broken-giobbe/ceci-hardware/README.md

# ceci-hardware
Hardware design files for our IoT sensor/actuator nodes based around the
ESP8266.

There are currently two hardware revisions:
 * rev0 (first prototype where sensor and actuator can be split)
 * rev1 (designed to act as a thermostat and fit into a vimar plana power box)
