broken-giobbe/ceci-hardware/ceci-gerbers/Transcode Report.txt

   ---- Transcoding 'C:\userdata\Arduino\ceci\ceci-hardware\ceci-gerbers\cece-pcb-B_Mask.gbr' ----   Wed Jul 21 10:57:14 2021

D17   --> D100
D18   --> D101
D19   --> D102
D20   --> D103
D21   --> D104
D22   --> D105
D24   --> D106
D25   --> D107
D26   --> D108
D27   --> D109
D28   --> D110
D29   --> D111
D30   --> D112
D31   --> D113
D32   --> D114
D33   --> D115
D34   --> D116
D35   --> D117
-----------------------------------------------------------------

   ---- Transcoding 'C:\userdata\Arduino\ceci\ceci-hardware\ceci-gerbers\cece-pcb-B_Paste.gbr' ----   Wed Jul 21 10:57:14 2021

D11   --> D118
D12   --> D119
D13   --> D120
D14   --> D121
-----------------------------------------------------------------

   ---- Transcoding 'C:\userdata\Arduino\ceci\ceci-hardware\ceci-gerbers\cece-pcb-B_SilkS.gbr' ----   Wed Jul 21 10:57:14 2021

D10   --> D122
D11   --> D123
D12   --> D124
-----------------------------------------------------------------

   ---- Transcoding 'C:\userdata\Arduino\ceci\ceci-hardware\ceci-gerbers\cece-pcb-Edge_Cuts.gbr' ----   Wed Jul 21 10:57:14 2021

D10   --> D125
D11   --> D126
-----------------------------------------------------------------

   ---- Transcoding 'C:\userdata\Arduino\ceci\ceci-hardware\ceci-gerbers\cece-pcb-F_Cu.gbr' ----   Wed Jul 21 10:57:14 2021

D17   --> D127
D18   --> D128
D19   --> D129
D20   --> D130
D21   --> D131
D22   --> D132
D24   --> D133
D25   --> D134
D26   --> D135
D27   --> D136
D28   --> D137
D29   --> D138
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

   ---- Transcoding 'C:\userdata\Arduino\ceci\ceci-hardware\ceci-gerbers\cece-pcb-F_SilkS.gbr' ----   Wed Jul 21 11:03:52 2021

D10   --> D158
D11   --> D159
D12   --> D160
-----------------------------------------------------------------
