broken-giobbe/ceci-hardware/cece-pcb.kicad_pcb

## KiCad design cece-pcb.kicad_pcb (2022-04-16)

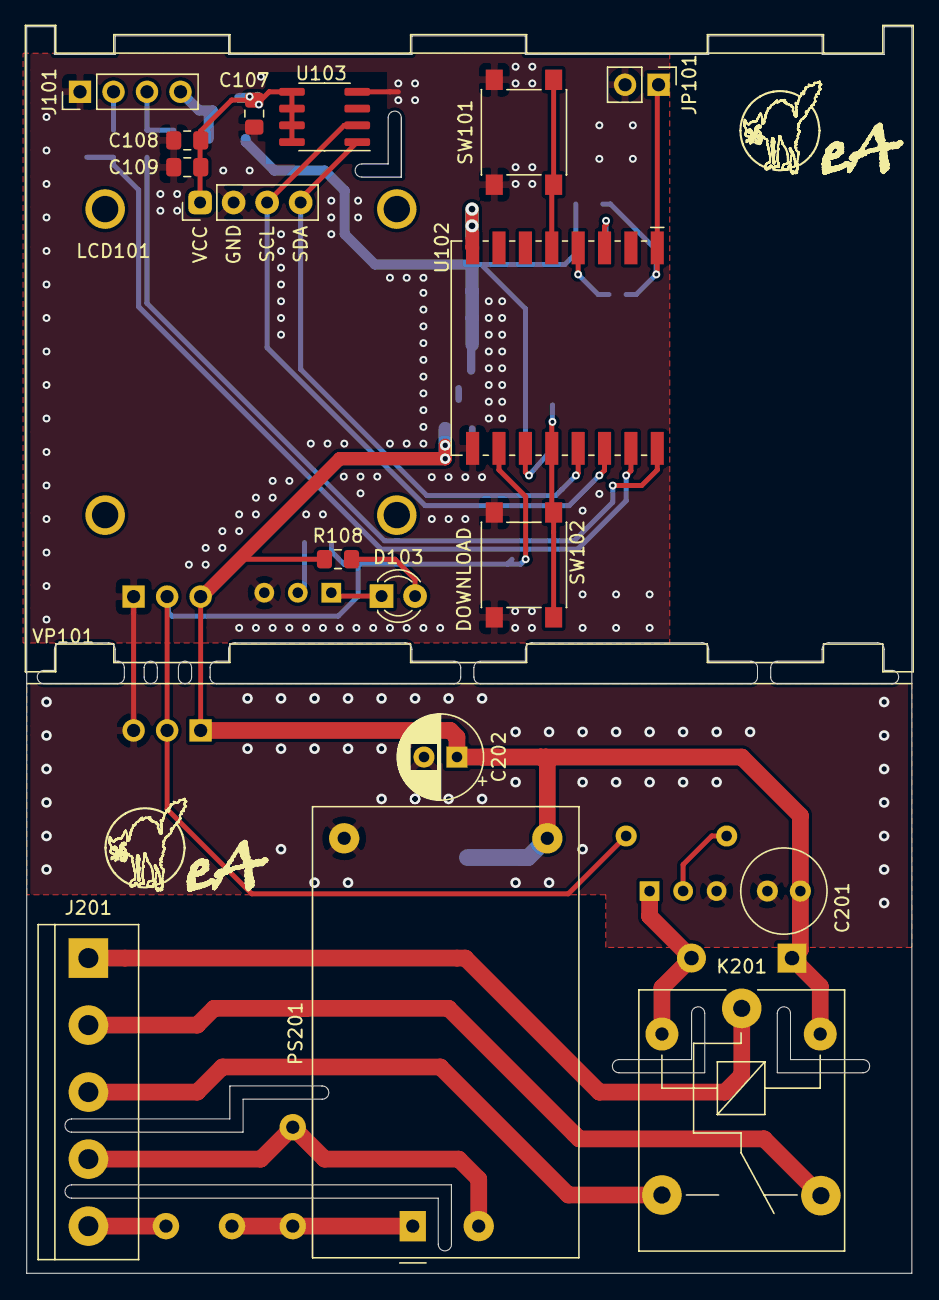
[picture p1: board cece-pcb.kicad_pcb from above]

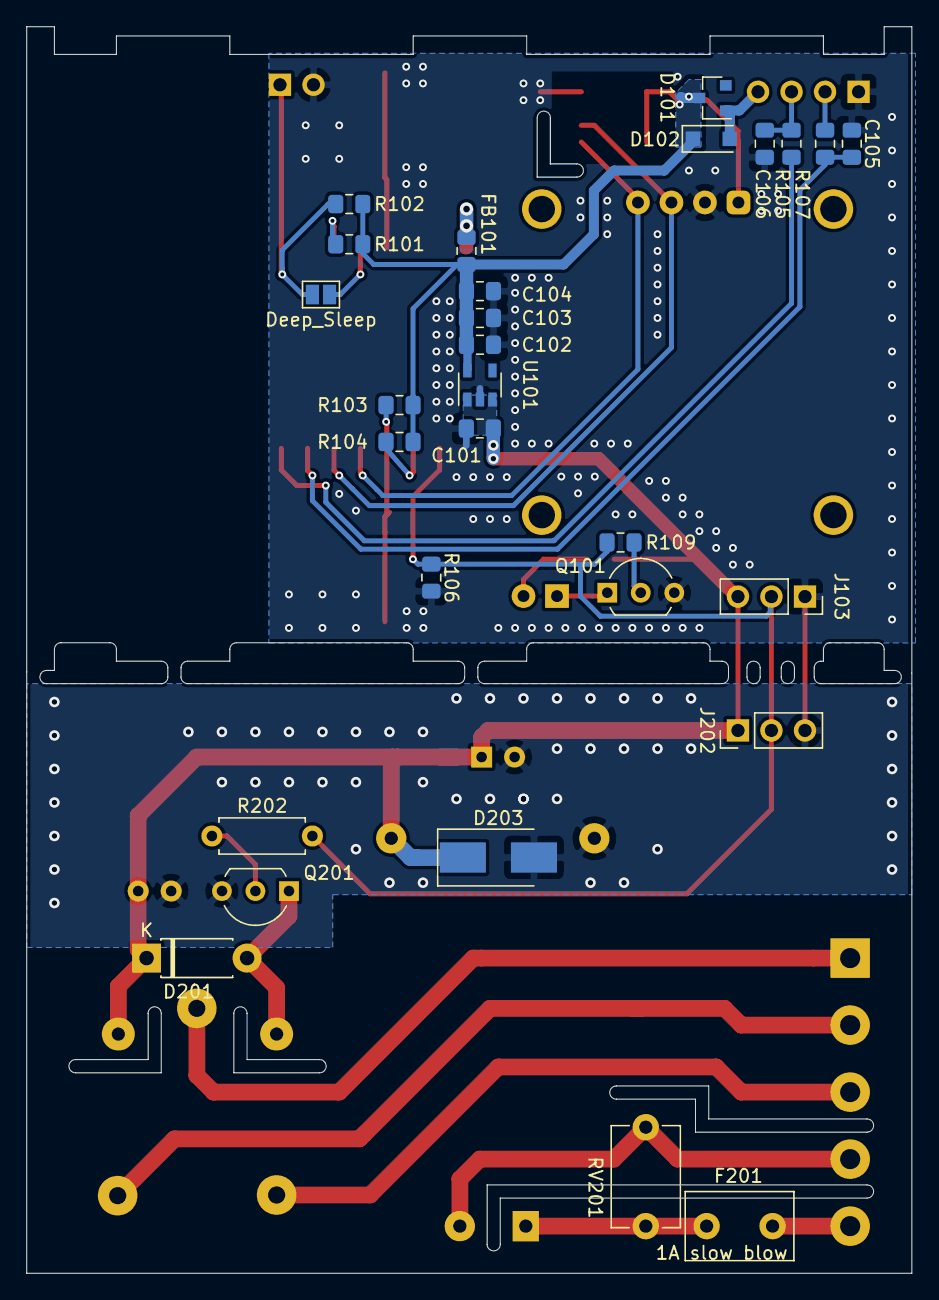
[picture p2: board cece-pcb.kicad_pcb from below]

Board: 2 copper layers, 67.1 x 94.5 mm, 48 parts (28 on the bottom side), 29 nets.

Parts:
C101, C103: 1u; C_0805_2012Metric_Pad1.15x1.40mm_HandSolder
C102, C108: 10u; C_0805_2012Metric_Pad1.15x1.40mm_HandSolder
C104, C107, C109: 100nF; C_0805_2012Metric_Pad1.15x1.40mm_HandSolder
C105, C106: 100p; C_0805_2012Metric_Pad1.15x1.40mm_HandSolder
C201: 10u; C_Radial_D6.3mm_H5.0mm_P2.50mm
C202: 100u; CP_Radial_D6.3mm_P2.50mm
D101: Schottky SOT-23; D_SOT-23_ANK
D102: Schottky SOD-123; D_SOD-123F
D103: LED; LED_D3.0mm
D201: 1N4001; D_DO-41_SOD81_P7.62mm_Horizontal
D203: SMBJ5.0A; D_SMB_Handsoldering
EA101, EA201: a_black_cat
F201: 1A slow blow; C_Disc_D8.0mm_W5.0mm_P5.00mm
FB101: Ferrite_Bead; R_0805_2012Metric_Pad1.15x1.40mm_HandSolder
J101: SERIAL; PinHeader_1x04_P2.54mm_Vertical
J103: Conn_01x03_Male; PinSocket_1x03_P2.54mm_Vertical
J201: VAC; TerminalBlock_bornier-5_P5.08mm
J202: Conn_01x03_Female; PinHeader_1x03_P2.54mm_Vertical
JP101: RST; PinHeader_1x02_P2.54mm_Vertical
JP103: Deep_Sleep; SolderJumper-2_P1.3mm_Open_Pad1.0x1.5mm
K201: SANYOU_SRD_Form_C; Relay_SPDT_SANYOU_SRD_Series_Form_C
LCD101: I2C_LCD_display; I2C_LCD_display_0.96
PS201: HLK-PM01; Converter_ACDC_HiLink_HLK-PMxx
Q101, Q201: Q_NPN; TO-92L_Inline_Wide
R101, R102, R103, R104, R106, R109: 10k; R_0805_2012Metric_Pad1.15x1.40mm_HandSolder
R105, R107, R108: 330; R_0805_2012Metric_Pad1.15x1.40mm_HandSolder
R202: 1k; R_Axial_DIN0207_L6.3mm_D2.5mm_P7.62mm_Horizontal
RV201: 10D561K; C_Disc_D7.5mm_W5.0mm_P7.50mm
SW101, SW102: SW_Push; SW_Push_1P1T_NO_6x6mm_H9.5mm
U101: TLV75533PDBV; SOT-23-5
U102: ESP-12F/ESP07; ESP-07
U103: LM75C; SOIC-8_3.9x4.9mm_P1.27mm
VP101: VimarPlana; vimar_plana_3P

Connections:
+3V3: C102.1, C103.1, C104.1, C107.1, C108.1, C109.1, D101.1, D102.1, FB101.2, LCD101.1, R101.2, R102.2, R103.2, R104.2, U101.5, U103.5, U103.6, U103.7, U103.8
+5V: C101.1, C201.1, C202.1, D201.1, D203.1, J103.3, J202.1, K201.5, PS201.4, R108.2, U101.1, U101.3
/Bottom Board/ACL: F201.2, J201.5
/Bottom Board/ACN: J201.4, PS201.2, RV201.2
/Bottom Board/C: J201.1, K201.1
/Bottom Board/NC: J201.2, K201.4
/Bottom Board/NO: J201.3, K201.3
/D0: JP103.2, U102.4
/D1|SCL: LCD101.3, U102.14, U103.2
/D2|SDA: LCD101.4, U102.13, U103.1
/D3: R103.1, SW102.1, U102.12
/D4: R104.1, U102.11
/D5|SCK: SW101.1, U102.5
/EN: R101.1, U102.3
/RST: JP101.1, JP103.1, R102.1, U102.1
/RX: C105.1, R107.2, U102.15
/TX: R105.2, U102.16
D8: J103.2, J202.2, R106.2, R109.2, R202.2, U102.10
GND: C101.2, C102.2, C103.2, C104.2, C105.2, C106.2, C107.2, C108.2, C109.2, C201.2, C202.2, D203.2, J101.1, J103.1, J202.3, JP101.2, LCD101.2, PS201.3, Q101.3, Q201.3, R106.1, SW101.2, SW102.2, U101.2, U102.9, U103.4
unnamed: C106.1, J101.3, R105.1
unnamed: D101.2, D102.2, J101.4
unnamed: D103.1, Q101.1
unnamed: D103.2, R108.1
unnamed: D201.2, K201.2, Q201.1
unnamed: F201.1, PS201.1, RV201.1
unnamed: FB101.1, U102.8
unnamed: J101.2, R107.1
unnamed: Q101.2, R109.1
unnamed: Q201.2, R202.1
