broken-giobbe/ceci-hardware/(commit log)

2020-11-29 Add firmware and PCB files
    [cece-pcb.kicad_pcb, cece-pcb.sch, esp_12_common.sch]
2020-12-01 Complete ESP-12 part of the PCB
    [cece-pcb.kicad_pcb, cece-pcb.sch, esp_12_common.sch]
2020-12-04 Finish first board revision
    [cece-pcb.kicad_pcb, cece-pcb.sch, esp_12_common.sch]
2020-12-04 Make board DRC-friendly
    [cece-pcb.kicad_pcb]
2020-12-04 Hang the ESP8266 antenna outside of the board for better RF performance
    [cece-pcb.kicad_pcb]
2020-12-04 More touches to the layout. Almost finished
    [cece-pcb.kicad_pcb, cece-pcb.sch]
2020-12-04 better grounding layout for regulator ICs
    [cece-pcb.kicad_pcb]
2020-12-05 Add jumper to send 5V directly to the LDO if no battery is installed
    [cece-pcb.kicad_pcb, cece-pcb.sch, esp_12_common.sch]
2020-12-06 Add gerber files
    [cece-pcb-B_Cu.gbr, cece-pcb-B_Mask.gbr, cece-pcb-B_Paste.gbr, cece-pcb-B_SilkS.gbr, cece-pcb-Edge_Cuts.gbr, cece-pcb-F_Cu.gbr, cece-pcb-F_Mask.gbr, cece-pcb-F_Paste.gbr]
2020-12-30 Fix wrong footprint for the pin headers
    [cece-pcb.kicad_pcb, cece-pcb.sch, esp_12_common.sch]
2021-01-06 Create gerbers with the fixed pin header size
    [cece-pcb-B_Cu.gbr, cece-pcb-B_Mask.gbr, cece-pcb-B_Paste.gbr, cece-pcb-B_SilkS.gbr, cece-pcb-Edge_Cuts.gbr, cece-pcb-F_Cu.gbr, cece-pcb-F_Mask.gbr, cece-pcb-F_Paste.gbr]
2021-02-03 Update component values
    [cece-pcb.sch]
2021-02-03 Update schematic references to reflect hierarchy
    [cece-pcb.sch, esp_12_common.sch]
2021-02-04 Boards have arrived. Fixed the many mistakes in the schematic
    [cece-pcb.sch, esp_12_common.sch]
2021-02-04 Update PCB
    [cece-pcb.kicad_pcb]
2021-02-09 Increase thermal relief size for easier hand soldering
    [cece-pcb.kicad_pcb]
2021-02-12 Add diode to protect the seral input when 3V3 are already supplied internally and shuffle stuff around a bit on the layout
    [cece-pcb.kicad_pcb, cece-pcb.sch]
2021-02-13 Add octave simulation files to test the heating algorithms
    [cece-pcb.kicad_pcb]
2021-02-22 Add resistor to limit peak current in the reset pushbutton. Prevents contact welding
    [cece-pcb.kicad_pcb, esp_12_common.sch]
2021-03-01 Add EA cat signature
    [cece-pcb.kicad_pcb]
2021-03-26 Use new stuff from pol lib
    [cece-pcb.kicad_pcb, cece-pcb.sch]
2021-04-08 Rename gerber files folder
    [cece-pcb-B_Cu.gbr, cece-pcb-B_Mask.gbr, cece-pcb-B_Paste.gbr, cece-pcb-B_SilkS.gbr, cece-pcb-Edge_Cuts.gbr, cece-pcb-F_Cu.gbr, cece-pcb-F_Mask.gbr, cece-pcb-F_Paste.gbr]
2021-04-08 Draft layout for the new HW revision (just for show)
    [cece-pcb.kicad_pcb]
2021-04-11 Improve ACDC converter design to make it more robust
    [cece-pcb.kicad_pcb, cece-pcb.sch]
2021-04-12 Separate top and bottom PCBs
    [bottom_board.sch, cece-pcb.sch, esp_12_common.sch]
2021-04-12 Start defining PCB
    [bottom_board.sch, cece-pcb.kicad_pcb, cece-pcb.sch]
2021-07-15 Complete the PCB ready for final review
    [cece-pcb.kicad_pcb, cece-pcb.sch]
2021-07-16 Fix slots shape
    [cece-pcb.kicad_pcb]
2021-08-11 Plot gerber files
    [cece-pcb-B_Cu.gbr, cece-pcb-B_Mask.gbr, cece-pcb-B_Paste.gbr, cece-pcb-B_SilkS.gbr, cece-pcb-Edge_Cuts.gbr, cece-pcb-F_Cu.gbr, cece-pcb-F_Mask.gbr, cece-pcb-F_Paste.gbr]
2021-08-11 Fix minor PCB mistakes and bump up the version to 1.01
    [bottom_board.sch, cece-pcb.kicad_pcb, cece-pcb.sch]
2021-08-13 Fix diode in the wrong direction and increase PCB revision to 1.02
    [cece-pcb.kicad_pcb, cece-pcb.sch]
2022-04-16 Update project to kicad 6 and move some components around
    [cece-pcb.kicad_pcb]
